ShubinJerry-Yuan/HomeSecurityLock/1.jpg

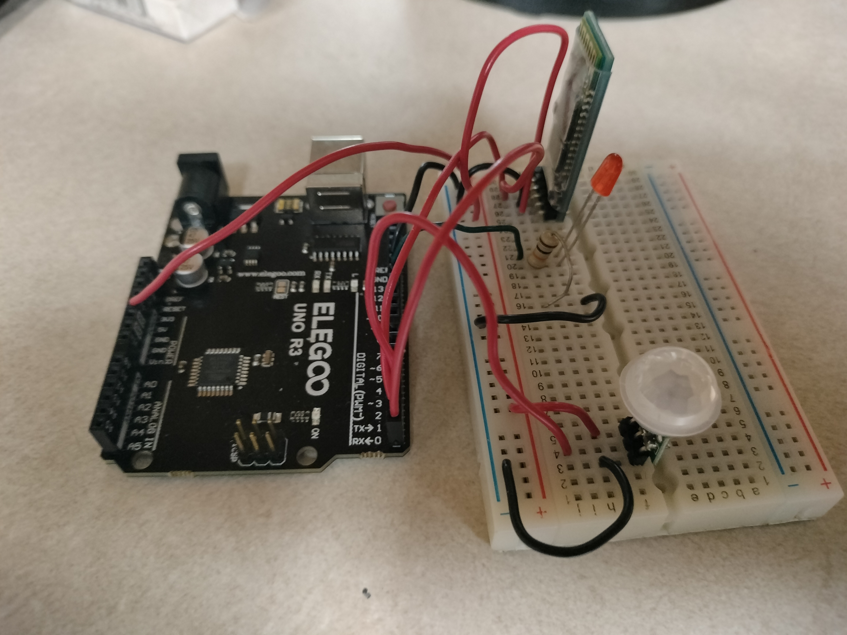
1.jpg
