ShubinJerry-Yuan/HomeSecurityLock/Apperance1.jpg

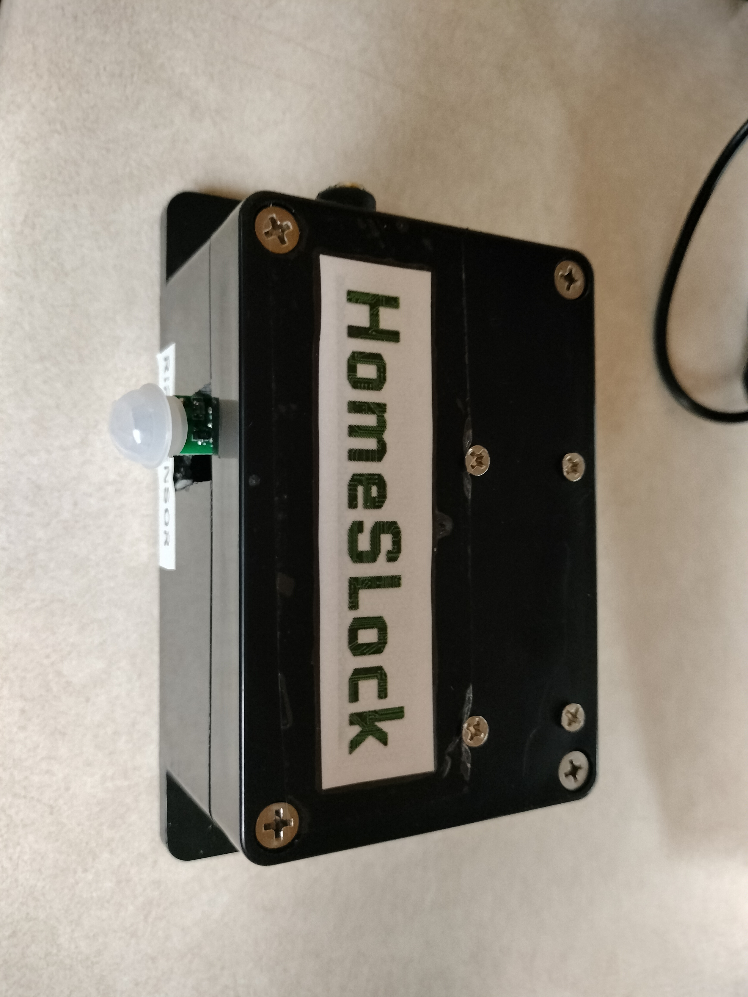
Apperance1.jpg
