ShubinJerry-Yuan/HomeSecurityLock/2.jpg

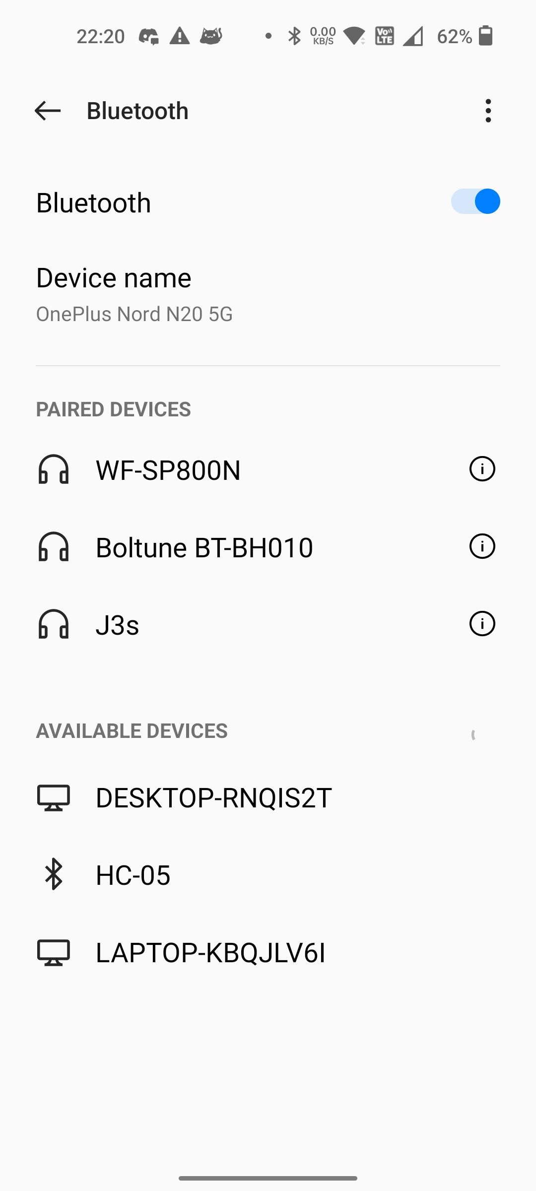
2.jpg
