ShubinJerry-Yuan/HomeSecurityLock/3.PNG

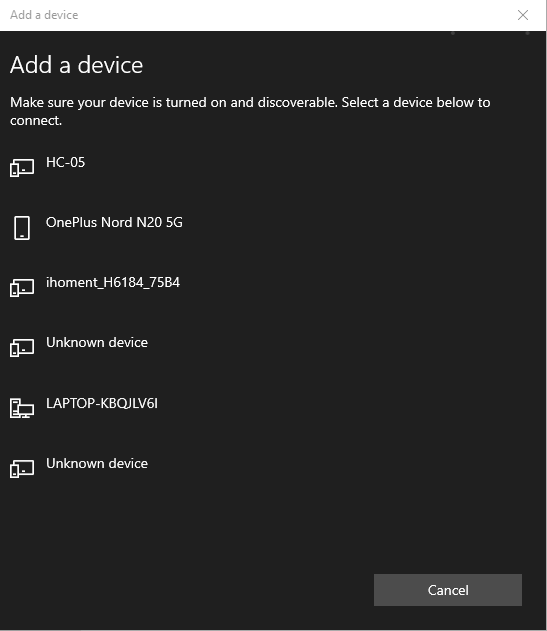
3.PNG
