ShubinJerry-Yuan/HomeSecurityLock/4.jpg

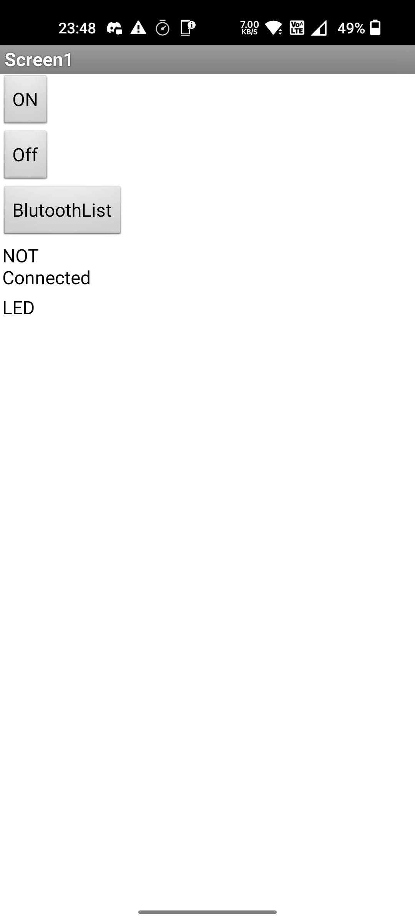
4.jpg
