ShubinJerry-Yuan/HomeSecurityLock/adapter.jpg

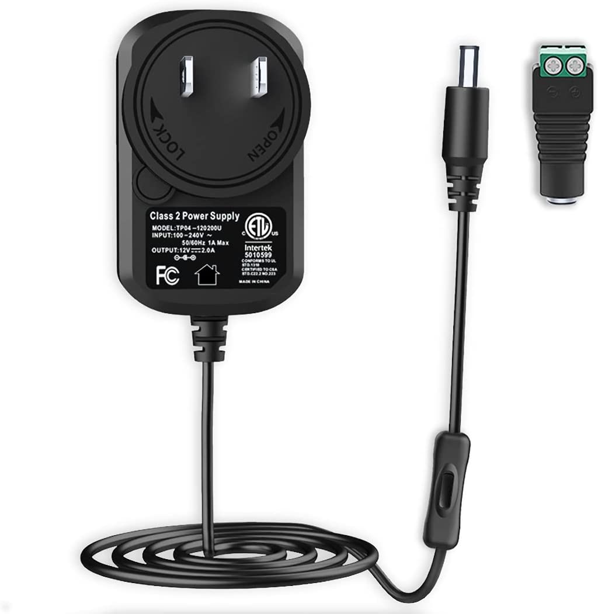
adapter.jpg
