ShubinJerry-Yuan/HomeSecurityLock/App code.PNG

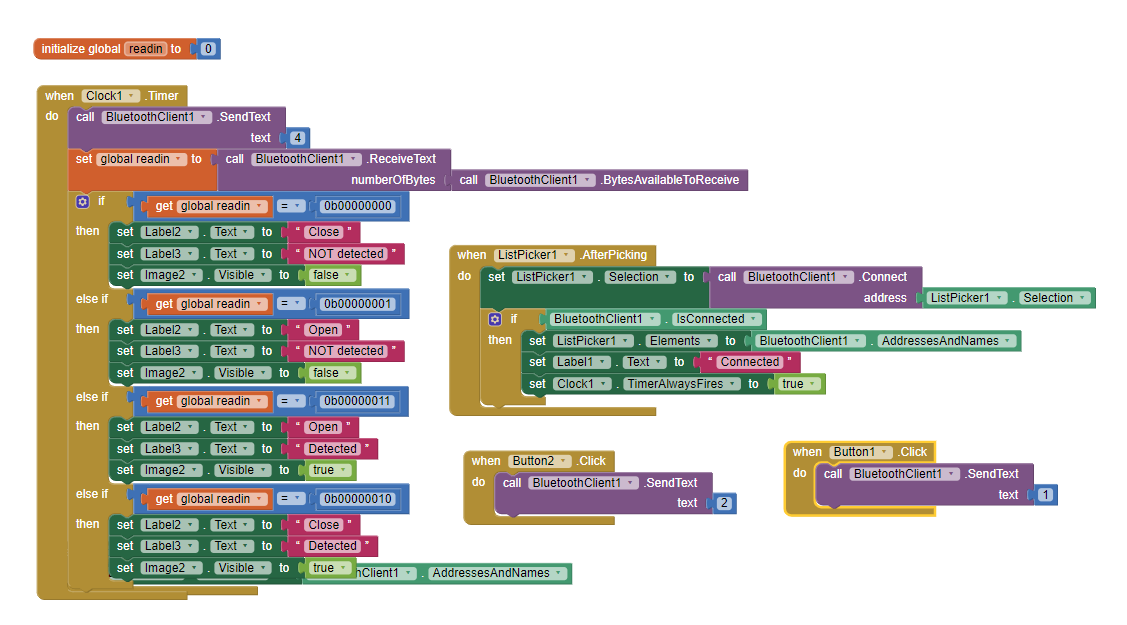
App code.PNG
