ShubinJerry-Yuan/HomeSecurityLock/bantam.PNG

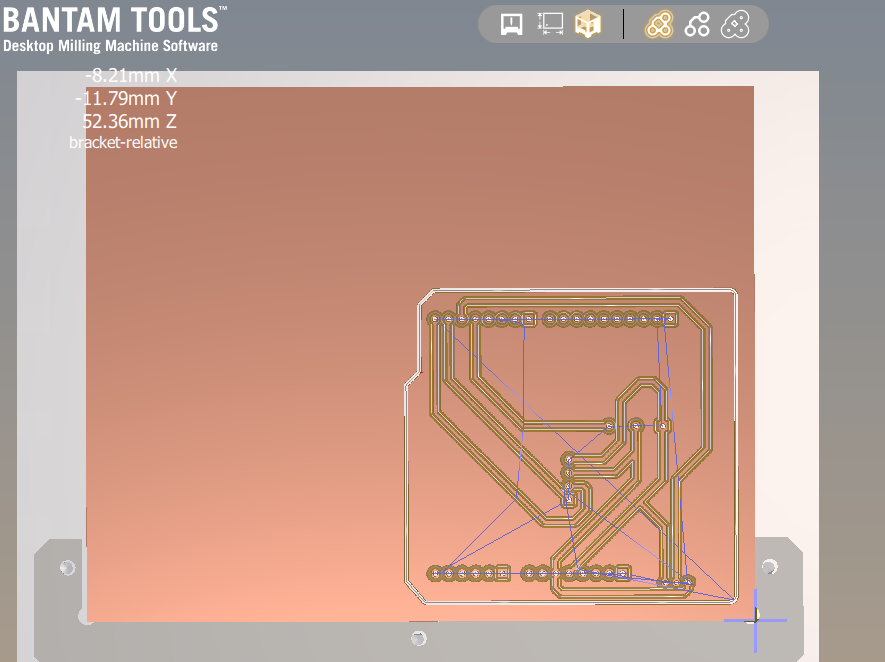
bantam.PNG
