ShubinJerry-Yuan/HomeSecurityLock/closed.jpg

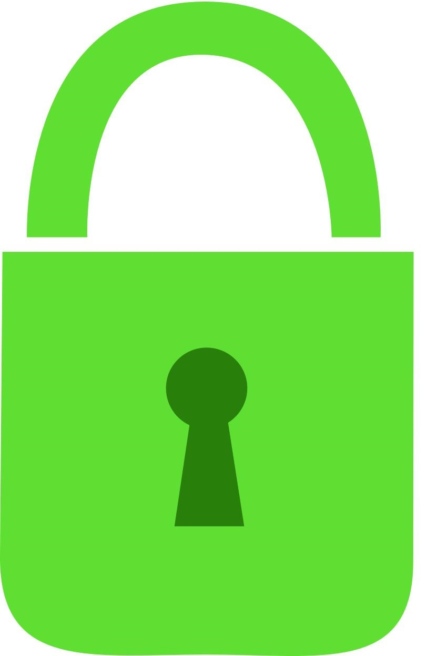
closed.jpg
