ShubinJerry-Yuan/HomeSecurityLock/disc - Copy.PNG

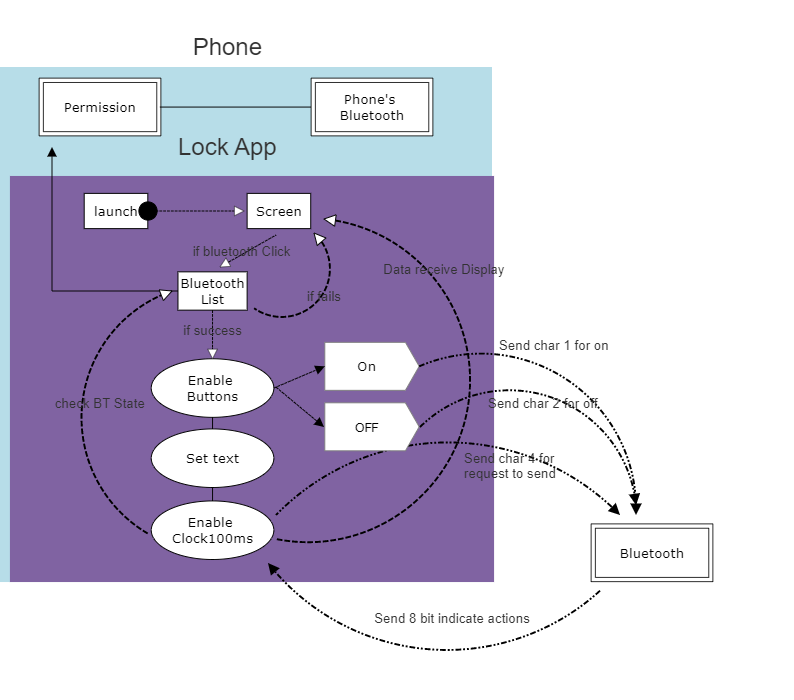
disc - Copy.PNG
