ShubinJerry-Yuan/HomeSecurityLock/greendot.png

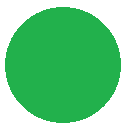
greendot.png
