ShubinJerry-Yuan/HomeSecurityLock/Mile4SC.png

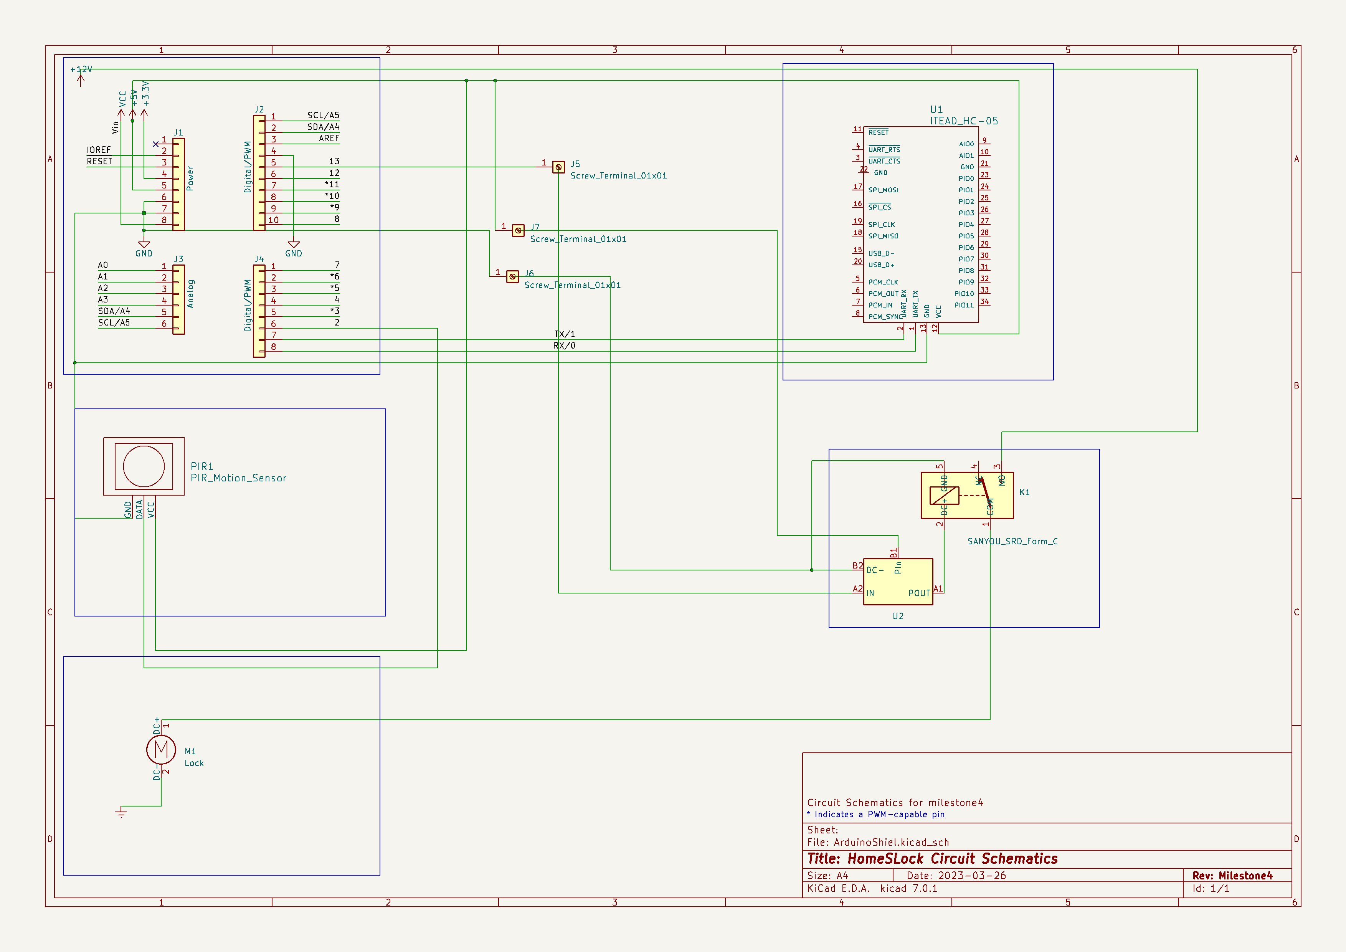
Mile4SC.png
