ShubinJerry-Yuan/HomeSecurityLock/open.png

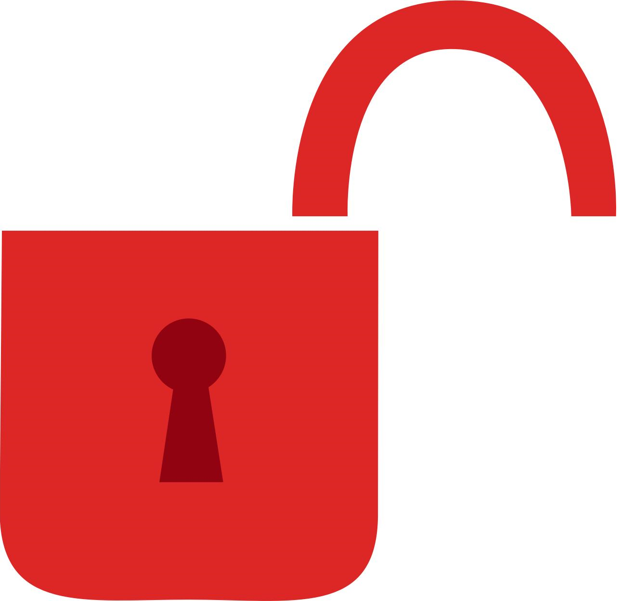
open.png
