ShubinJerry-Yuan/HomeSecurityLock/physicalDigram.PNG

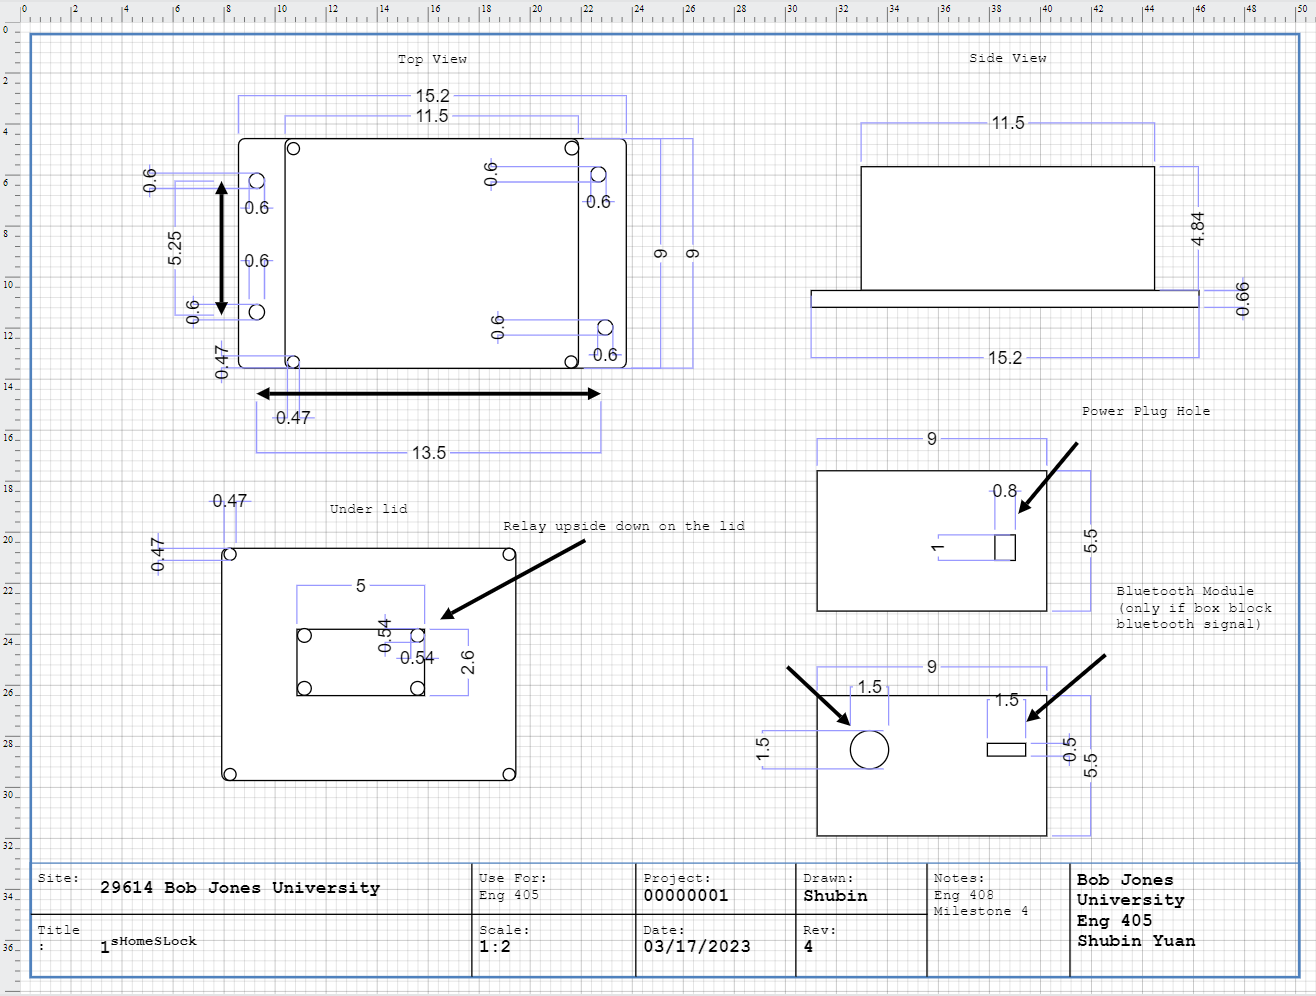
physicalDigram.PNG
