ShubinJerry-Yuan/HomeSecurityLock/pinc.jpg

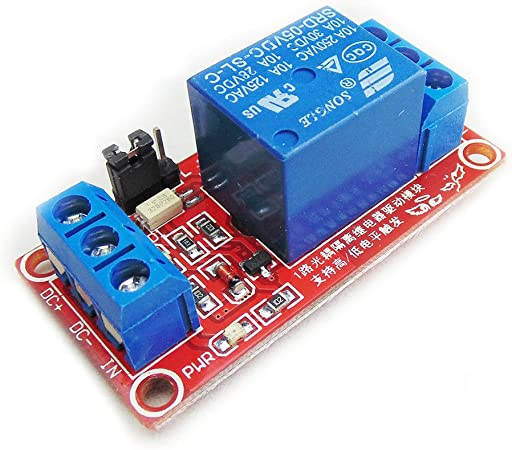
pinc.jpg
