ShubinJerry-Yuan/HomeSecurityLock/QQ图片20230302233803.jpg

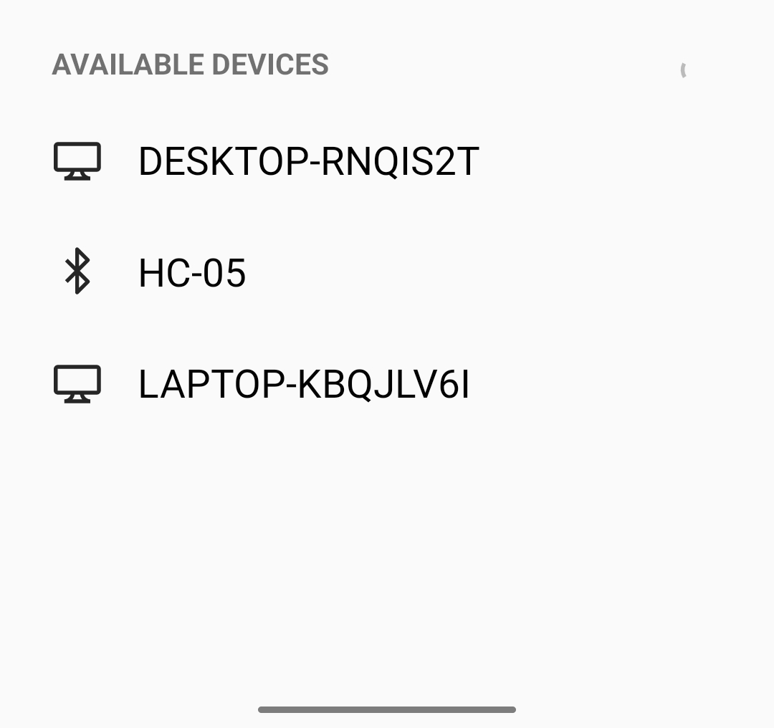
QQ图片20230302233803.jpg
