ShubinJerry-Yuan/HomeSecurityLock/software.PNG

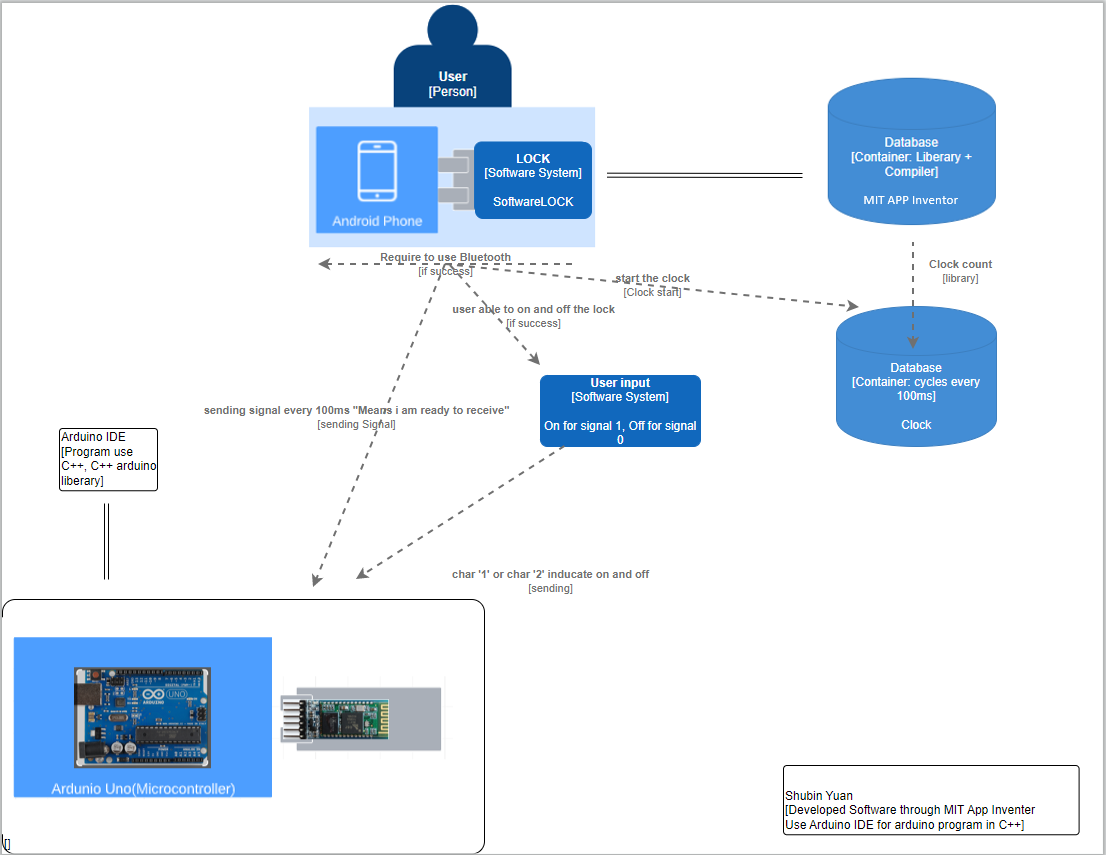
software.PNG
