ShubinJerry-Yuan/HomeSecurityLock/u.PNG

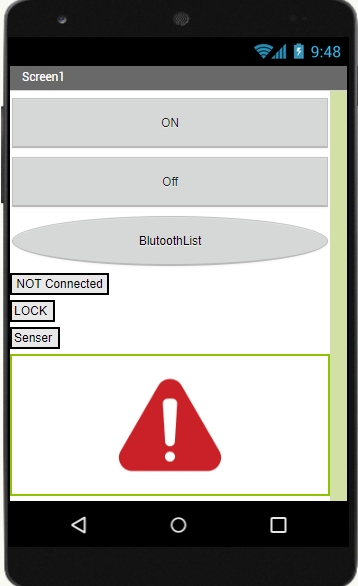
u.PNG
