ShubinJerry-Yuan/HomeSecurityLock/BOM.pdf

Template | Bill of Materials | Totals: | $ | 0.838 59.39 | [lb] | $ | 72.24
Shubin Yuan | Do not change blue (calculated) squares
PARTS LIST
RefID | Part Name | Technical Description | Mfgr Name | Mfgr Part No | Name | Part/Catalog No | Web Address | Qty | Unit | Total | Unit [lb] | Total [lb] | Qty Total Cost [$] End-of-Life | Notes
P2 | PIR Motion Sensor Detector | Onyehn IR Pyroelectric Infrared PIR Motion Sensor Detector Modules DC 2.7 to 12V(Pack of 2pcs) Onyehn | 8741774811 | Onyehn | B07GJDJV63 | https://www.amazon.com/Onyehn-Pyroelectric-Infrared-Detector-Modules/dp/B07GJDJV63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 1 | 1.831666667 1.831666667 | 0.039625 | 0.039625 | 6 | 10.99 Recycle | sensor
P1 | Arduino Uno | ELEGOO UNO R3 Board ATmega328P | ELEGOO | EL-CB-001 | ELEGOO | B01EWOE0UU | https://www.amazon.com/ELEGOO-Board-ATmega328P-ATMEGA16U2-Compliant/dp/B01EWOE0UU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 1 | 16.99 | 16.99 | 0.06 | 0.06 | 1 | 16.99 Recycle | Microprocessor
U1 | Relay | HiLetgo 5V relay | HiLetgo | 3-01-0340 | HiLetgo | B00LW15A4W | https://www.amazon.com/HiLetgo-Channel-optocoupler-Support-Trigger/dp/B00LW15A4W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 1 | 3.695 | 3.695 | 0.149375 | 0.149375 | 2 | 7.39 Recycle | PBC relative recycle
P3 | Bluetooth Transceriver | Wireless Bluetooth RF Transceiver | HiLetgo | 8541554474 | HiLetgo | B071YJG8DR | https://www.amazon.com/HiLetgo-Wireless-Bluetooth-Transceiver-Arduino/dp/B071YJG8DR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 1 | 10.39 | 10.39 | 0.00775 | 0.00775 | 1 | 10.39 Recycle | Bluetooth
L1 | Lock | uxcell DC 12V 1.1A 11.4mm Electromagnetic Solenoid Lock | uxcell | a19042500ux0016uxcell | B07TMWY94C | https://www.amazon.com/uxcell-Electromagnetic-Solenoid-Assembly-Electirc/dp/B07TMWY94C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 1 | 15.49 | 15.49 | 0.3625 | 0.3625 | 1 | 15.49 Recycle | Lock
V1 | Power Supply | F1TP DC 12V 2A Power Supply Adapter | F1TP | TP04-120200U F1TP | B078R93PSY | https://www.amazon.com/F1TP-Adapter-Charger-Digital-Keyboard/dp/B078R93PSY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 1 | 10.99 | 10.99 | 0.21875 | 0.21875 | 1 | 10.99 Recycle | Power supply
Manufacturer | Vendor | Product Cost [$] | Mass | Purchased
