ShubinJerry-Yuan/HomeSecurityLock/Eng 405 BoM.xlsx

Sheet: READ!
PLEASE READ THESE NOTES AND FOLLOW THESE INSTRUCTIONS …
Cell | Name | Notes
A1 |  | replace with the official name of your product
A2 |  | replace with your name
1:4 |  | do not change any other cells here; stretch column widths as needed.
Starting in row 5: (Example in this row should be replaced)
 | Item | An alpha nummeric unique to each line/part. A scheme may be used to group parts by assemblies. These Part Numbers must appear on your circuit schematic or assembly drawing.
 | Part Name | Your name for this part which denotes its function; exactly the same as will appear on your assembly and/or detail drawing. Ex: Screw, Cover
 | Technical Description | More detailed, descriptive, generic name; could be from the manufacturer. Ex: Hex Head Machine Screw, 1/4-28 x 1.125
 | Manufacturer's Name | Who actually manufactures the part?
 | Mfgr's Part No
 | Vendor's Name | Vendor/Supplier/Distributor: from whom you are buying the part.
 | Vendor's Part/Catalog No
 | Vendor's Address | Physical or web address.
 | Qty - Product | Quantity: Total number of this exact part in your product. (Do NOT list the same part multiple times because it is used in different places/applications).
 | Unit Cost | CALCULATED: Cost per part [$] = Total Purchase Cost/Quantity Purchased
 | Total Cost - Product | CALCULATED: Qty * Unit Cost [$]. Total of this column (Total Product Cost) appears in Row 1.
 | Unit Mass | Weight/mass per piece; you may pick the units, but it must be the same for all parts so the sum makes sense. Add [unit] to column header. Not crucial for electrical parts.
 | Total Mass | CALCULATED: Qty * Unit Weight; create a column sum for entire product at top.
 | End-of-Life | Discard, Recycle or Hazardous. Consult manufacturer data sheets where available. If you list Hazardous or Recycle, you must describe how/where to dispose.
 | Qty Purchased | Quantity: Total number you were required to purchase.
 | Total Purchase Cost | Total amount you spend for the purchased quantity. Include shipping. Total of this column (Total Project Cost) appears in Row 1.
 | NOTE: | Cells with formulas have a blue font to help prevent entering data there.

Sheet: BoM
Template |  | Bill of Materials |  |  |  |  | Totals: |  |  | $64.97 |  | 1.371 | [lb] |  | $103.12
Shubin Yuan |  | Do not change blue (calculated) squares
PARTS LIST |  |  | Manufacturer |  | Vendor |  |  |  | Product Cost [$] |  | Mass |  |  | Purchased
RefID | Part Name | Technical Description | Mfgr Name | Mfgr Part No | Name | Part/Catalog No | Web Address | Qty | Unit | Total | Unit [lb] | Total [lb] |  | Qty | Total Cost [$] | End-of-Life | Notes
P2 | PIR Motion Sensor Detector | Onyehn IR Pyroelectric Infrared PIR Motion Sensor Detector Modules DC 2.7 to 12V(Pack of 2pcs) | Onyehn | 8741774811 | Onyehn | B07GJDJV63 | https://www.amazon.com/Onyehn-Pyroelectric-Infrared-Detector-Modules/dp/B07GJDJV63?hvadid=241986369569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 | 1 | 1.831666667 | 1.831666667 | 0.039625 | 0.039625 |  | 6 | 10.99 | Recycle | sensor
P1 | Arduino Uno | ELEGOO UNO R3 Board ATmega328P | ELEGOO | EL-CB-001 | ELEGOO | B01EWOE0UU | https://www.amazon.com/ELEGOO-Board-ATmega328P-ATMEGA16U2-Compliant/dp/B01EWOE0UU?hvadid=309751315916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 (https://www.amazon.com/gp/product/B0924VCP2R/ref=ppx_yo_dt_b_asin_title_o00_s00?ie=UTF8&psc=1) | 1 | 16.99 | 16.99 | 0.06 | 0.06 |  | 1 | 16.99 | Recycle | Microprocessor
U1 | Relay | HiLetgo 5V relay | HiLetgo | 3-01-0340 | HiLetgo | B00LW15A4W | https://www.amazon.com/HiLetgo-Channel-optocoupler-Support-Trigger/dp/B00LW15A4W | 1 | 3.695 | 3.695 | 0.149375 | 0.149375 |  | 2 | 7.39 | Recycle | PBC relative recycle
P3 | Bluetooth Transceriver | Wireless Bluetooth RF Transceiver | HiLetgo | 8541554474 | HiLetgo | B071YJG8DR | https://www.amazon.com/HiLetgo-Wireless-Bluetooth-Transceiver-Arduino/dp/B071YJG8DR | 1 | 10.39 | 10.39 | 0.00775 | 0.00775 |  | 1 | 10.39 | Recycle | Bluetooth
L1 | Lock | uxcell DC 12V 1.1A 11.4mm Electromagnetic Solenoid Lock | uxcell | ‎a19042500ux0016 | uxcell | B07TMWY94C | https://www.amazon.com/uxcell-Electromagnetic-Solenoid-Assembly-Electirc/dp/B07TMWY94C?s=hi | 1 | 15.49 | 15.49 | 0.3625 | 0.3625 |  | 1 | 15.49 | Recycle | Lock
V1 | Power Supply | F1TP DC 12V 2A Power Supply Adapter | F1TP | TP04-120200U | F1TP | B078R93PSY | https://www.amazon.com/F1TP-Adapter-Charger-Digital-Keyboard/dp/B078R93PSY | 1 | 10.99 | 10.99 | 0.21875 | 0.21875 |  | 1 | 10.99 | Recycle | Power supply
B1 | Case | Electronic Project Box | Pinfox | 2042776462 | Pinfox | B08MCZ17HW | https://www.amazon.com/dp/B08MCZ17HW?ref=ppx_pop_mob_ap_share&th=1 | 1 | 5.495 | 5.495 | 0.529375 | 0.529375 |  | 2 | 10.99 | Recycle | Plastic ABS
C1 | screw | Flat Head Machine Screws | binifiMux | ‎CF-242 | binifiMux | B07XMCW7NV | https://www.amazon.com/binifiMux-Phillips-Countersunk-Assortment-Stainless/dp/B07XMCW7NV?s=industrial | 4 | 0.02115957447 | 0.08463829787 | 0.001 | 0.004 |  | 940 | 19.89 | Recycle | Stainless Steel
