ShubinJerry-Yuan/HomeSecurityLock/Mile4PrintS2.PNG

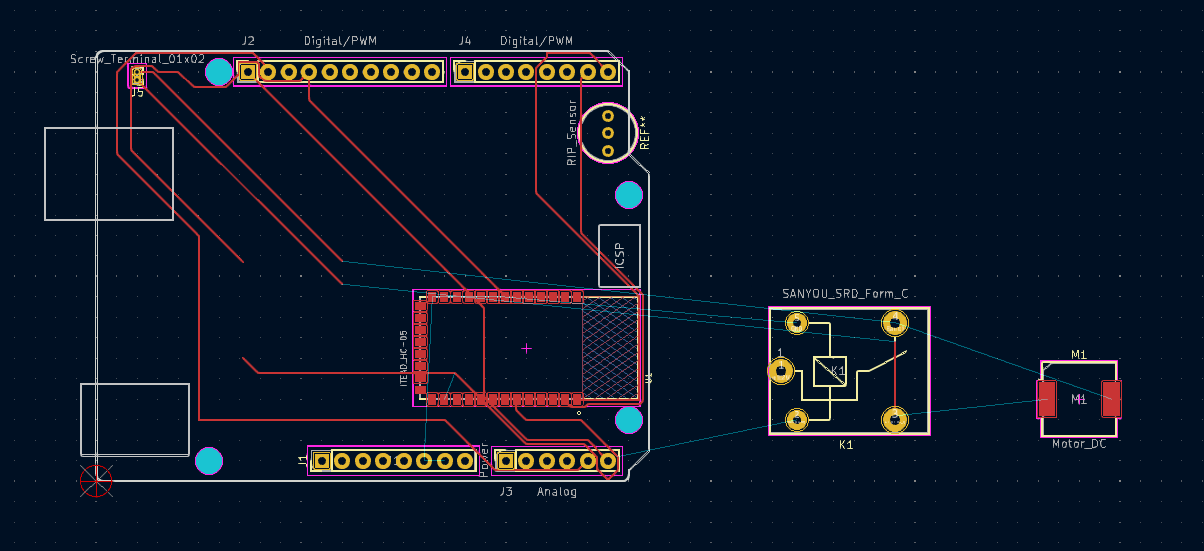
Mile4PrintS2.PNG
