ShubinJerry-Yuan/HomeSecurityLock/Mile4PrintS23.PNG

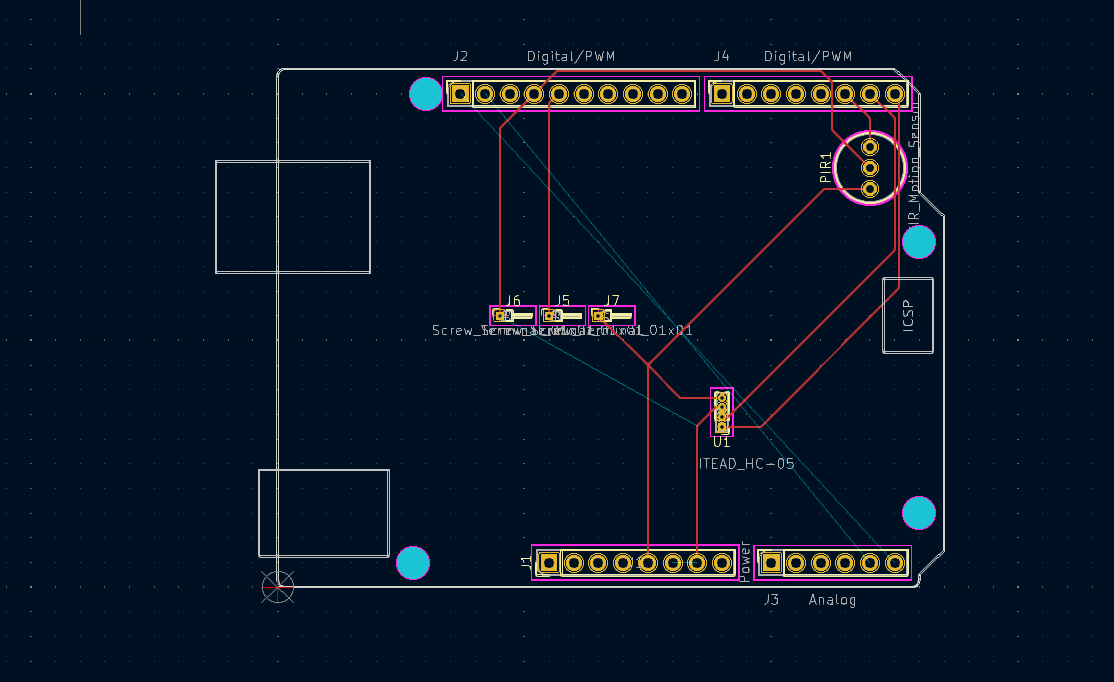
Mile4PrintS23.PNG
