ShubinJerry-Yuan/HomeSecurityLock/Mile4PrintS.PNG

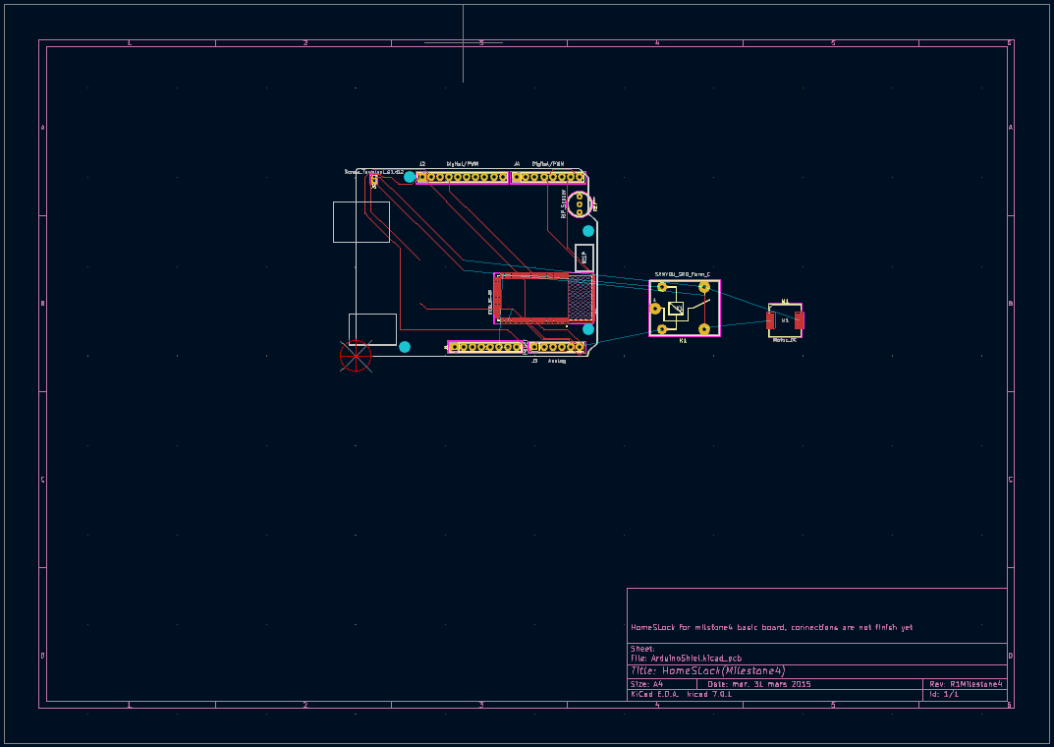
Mile4PrintS.PNG
