ShubinJerry-Yuan/HomeSecurityLock/(list of files, drawings)

Other design files:
ArduinoShiel.dsn
